Red-Lucy-Engineering/misfits/README.md

# "Misfits" - e-Paper (smart)watch

Open hardware e-Paper based smartwatch, fully user programmable.

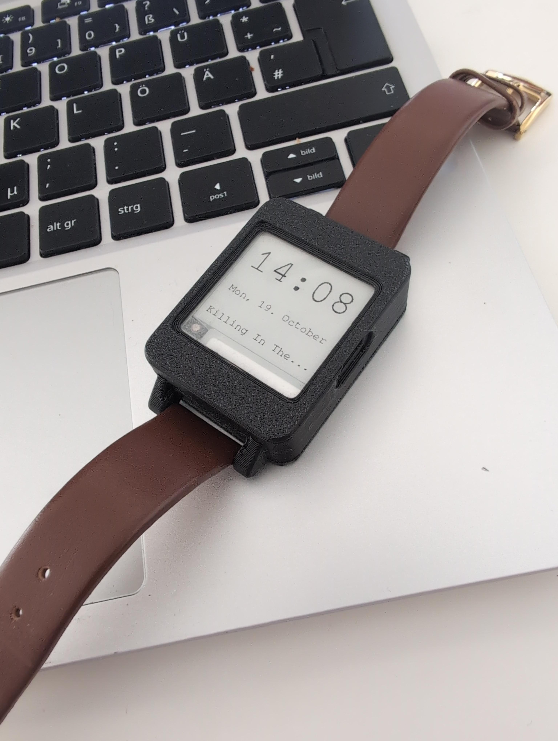
[picture p1: readme-media/misfits_assembled.jpg]
misfits assembled prototype

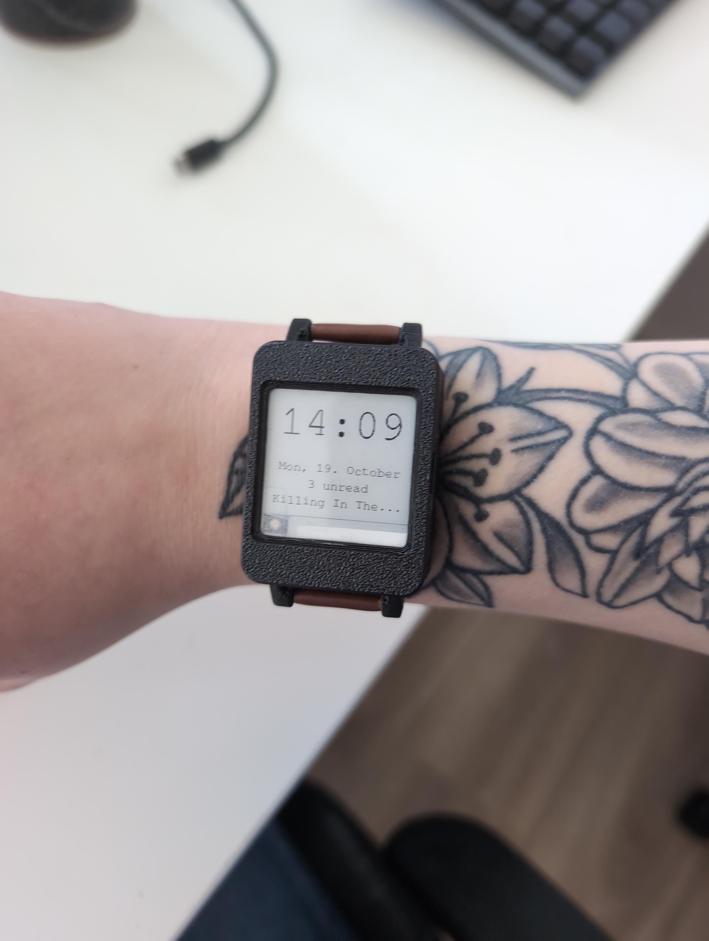
[picture p2: readme-media/misfits_assembled_wrist.jpg]
misfits assembled prototype, worn

misfits fixed prototype PCB, front
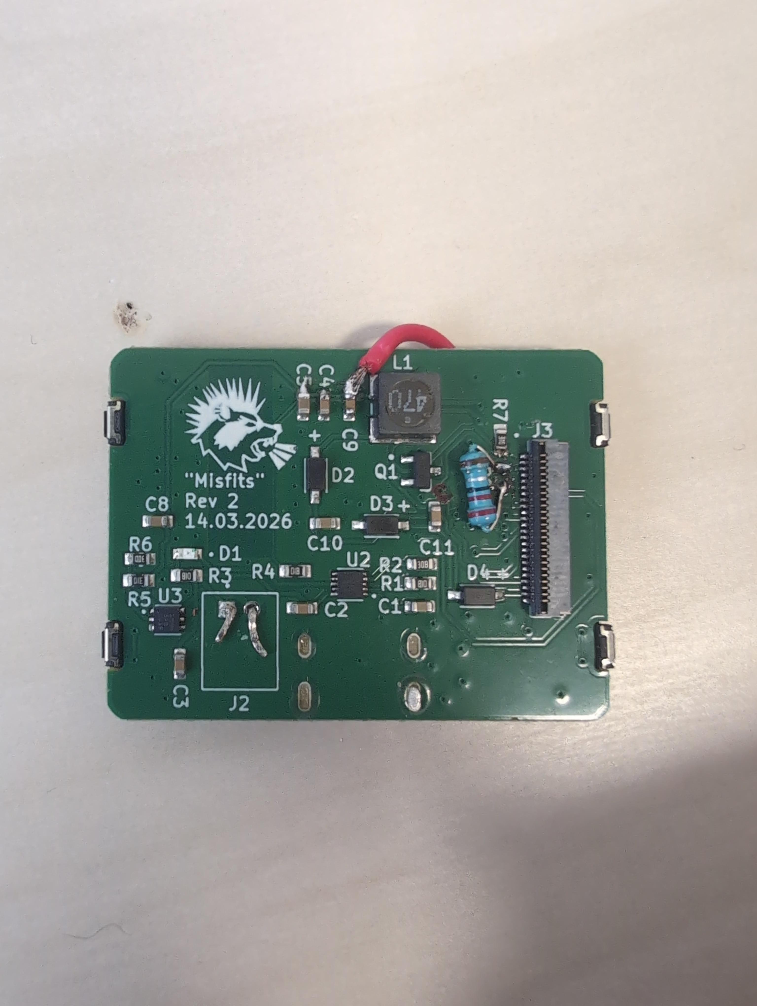
[picture p3: readme-media/misfits_fixed_pcb_back.jpg]
misfits fixed prototype PCB, back

misfits prototype without chassis
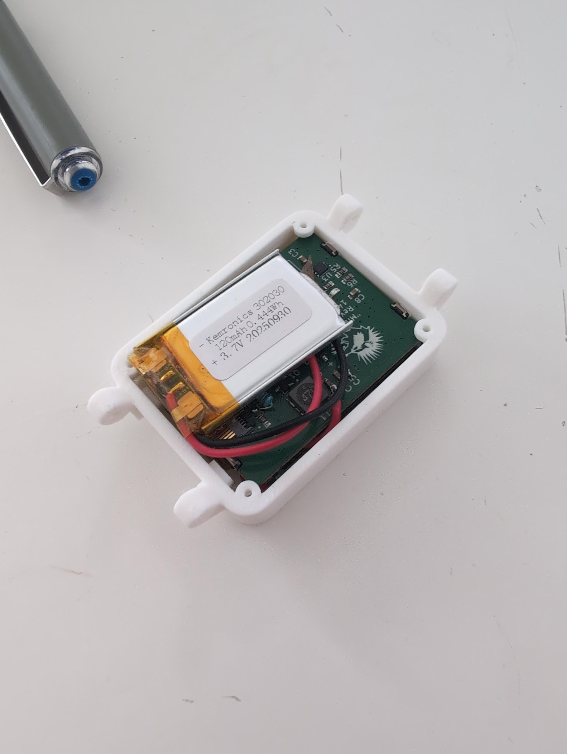
[picture p4: readme-media/misfits_partially_assembled.jpg]
misfits prototype partially assembled
