Red-Lucy-Engineering/misfits/readme-media/misfits-rev1-pcbdesign.png

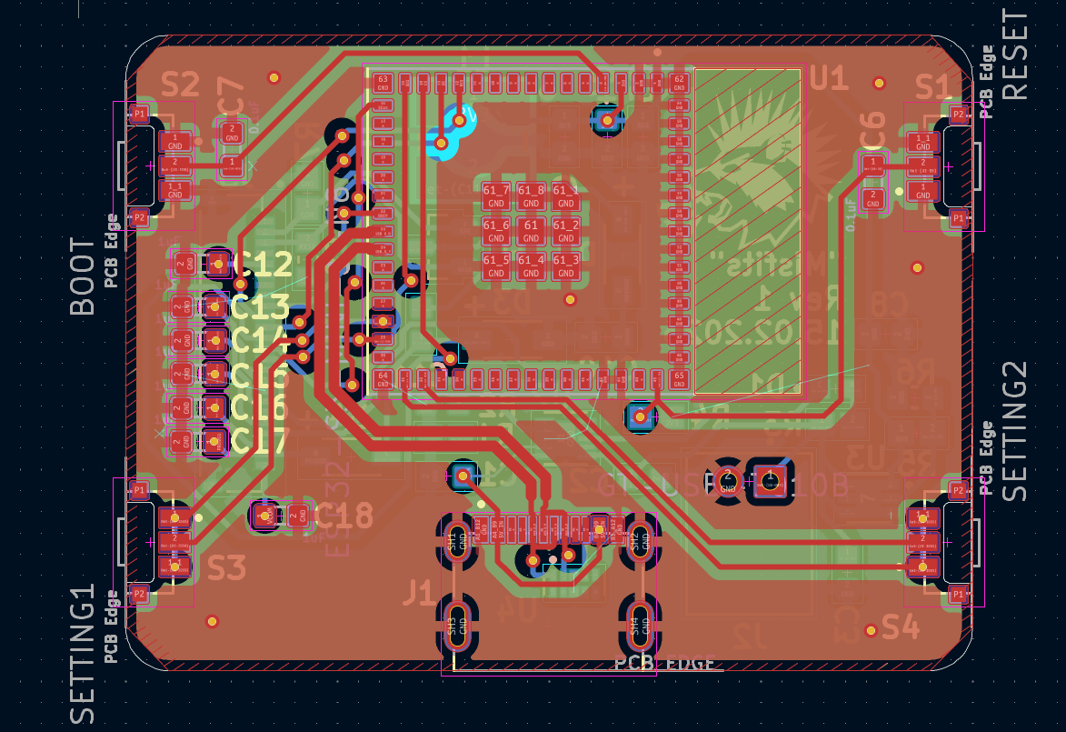
readme-media/misfits-rev1-pcbdesign.png
