Red-Lucy-Engineering/misfits/readme-media/misfits_no_chasiss.jpg

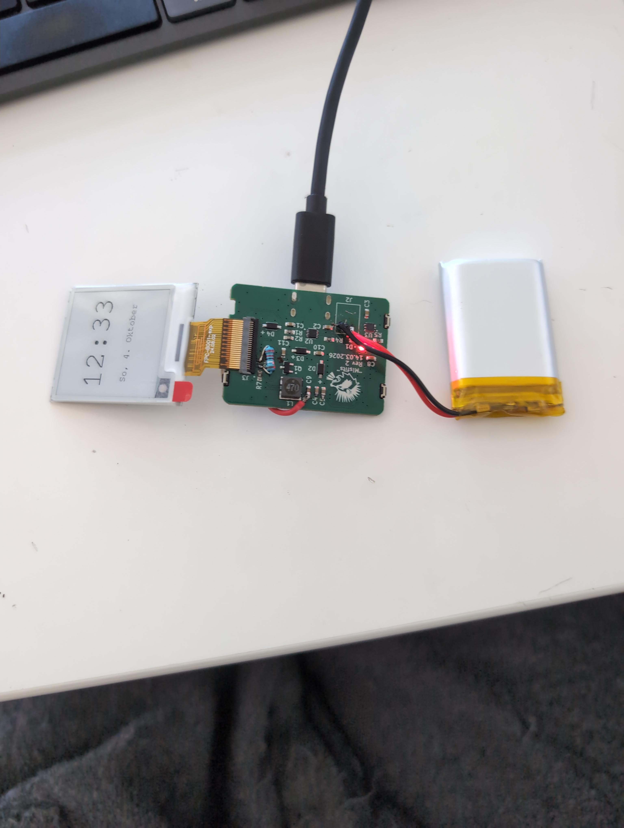
readme-media/misfits_no_chasiss.jpg
