Red-Lucy-Engineering/misfits/chassis/caseback.stl

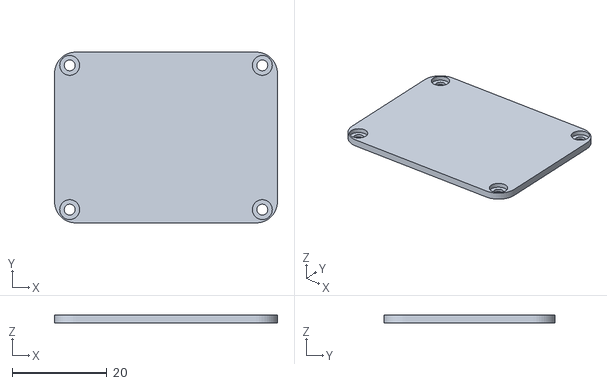
[picture p7: CAD file, 2026-10-24]
chassis/caseback.stl
47.0 x 36.0 x 1.60
