Red-Lucy-Engineering/misfits/chassis/body.stl

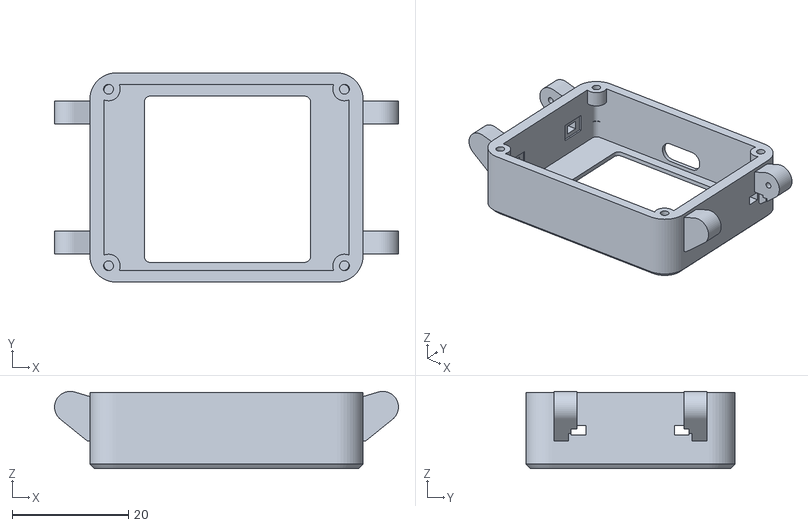
[picture p8: CAD file, 2026-10-24]
chassis/body.stl
59.2 x 36.0 x 13.3
