Red-Lucy-Engineering/misfits/TODO.md

# TODOs

- [x] Fix design mistakes
    - [x] *So* many grounds aren't connected because of shitty KiCAD zone defaults
    - [x] Correct placement of ESD protection chip
- [ ] Reduce component/assembly cost (currently $181.20 for 5 rev1 boards)
    - [ ] Panelize (Have multiple boards on a single PCB panel to avoid minimum
          assembly charges)
    - [x] Use cheaper parts, check for stock
        - [ ] SMT USB-C port, reduces hand assembly stuff
- [ ] Changes and New features
    - [ ] Better Microcontroller placement (less/no GND around the antenna)
    - [ ] Vibration motor
    - [ ] Heartrate monitor? (Optional, won't be added if there's no space or
          requires redesign)
