Red-Lucy-Engineering/misfits/misfits.kicad_pcb

## KiCad design misfits.kicad_pcb (2026-09-28)

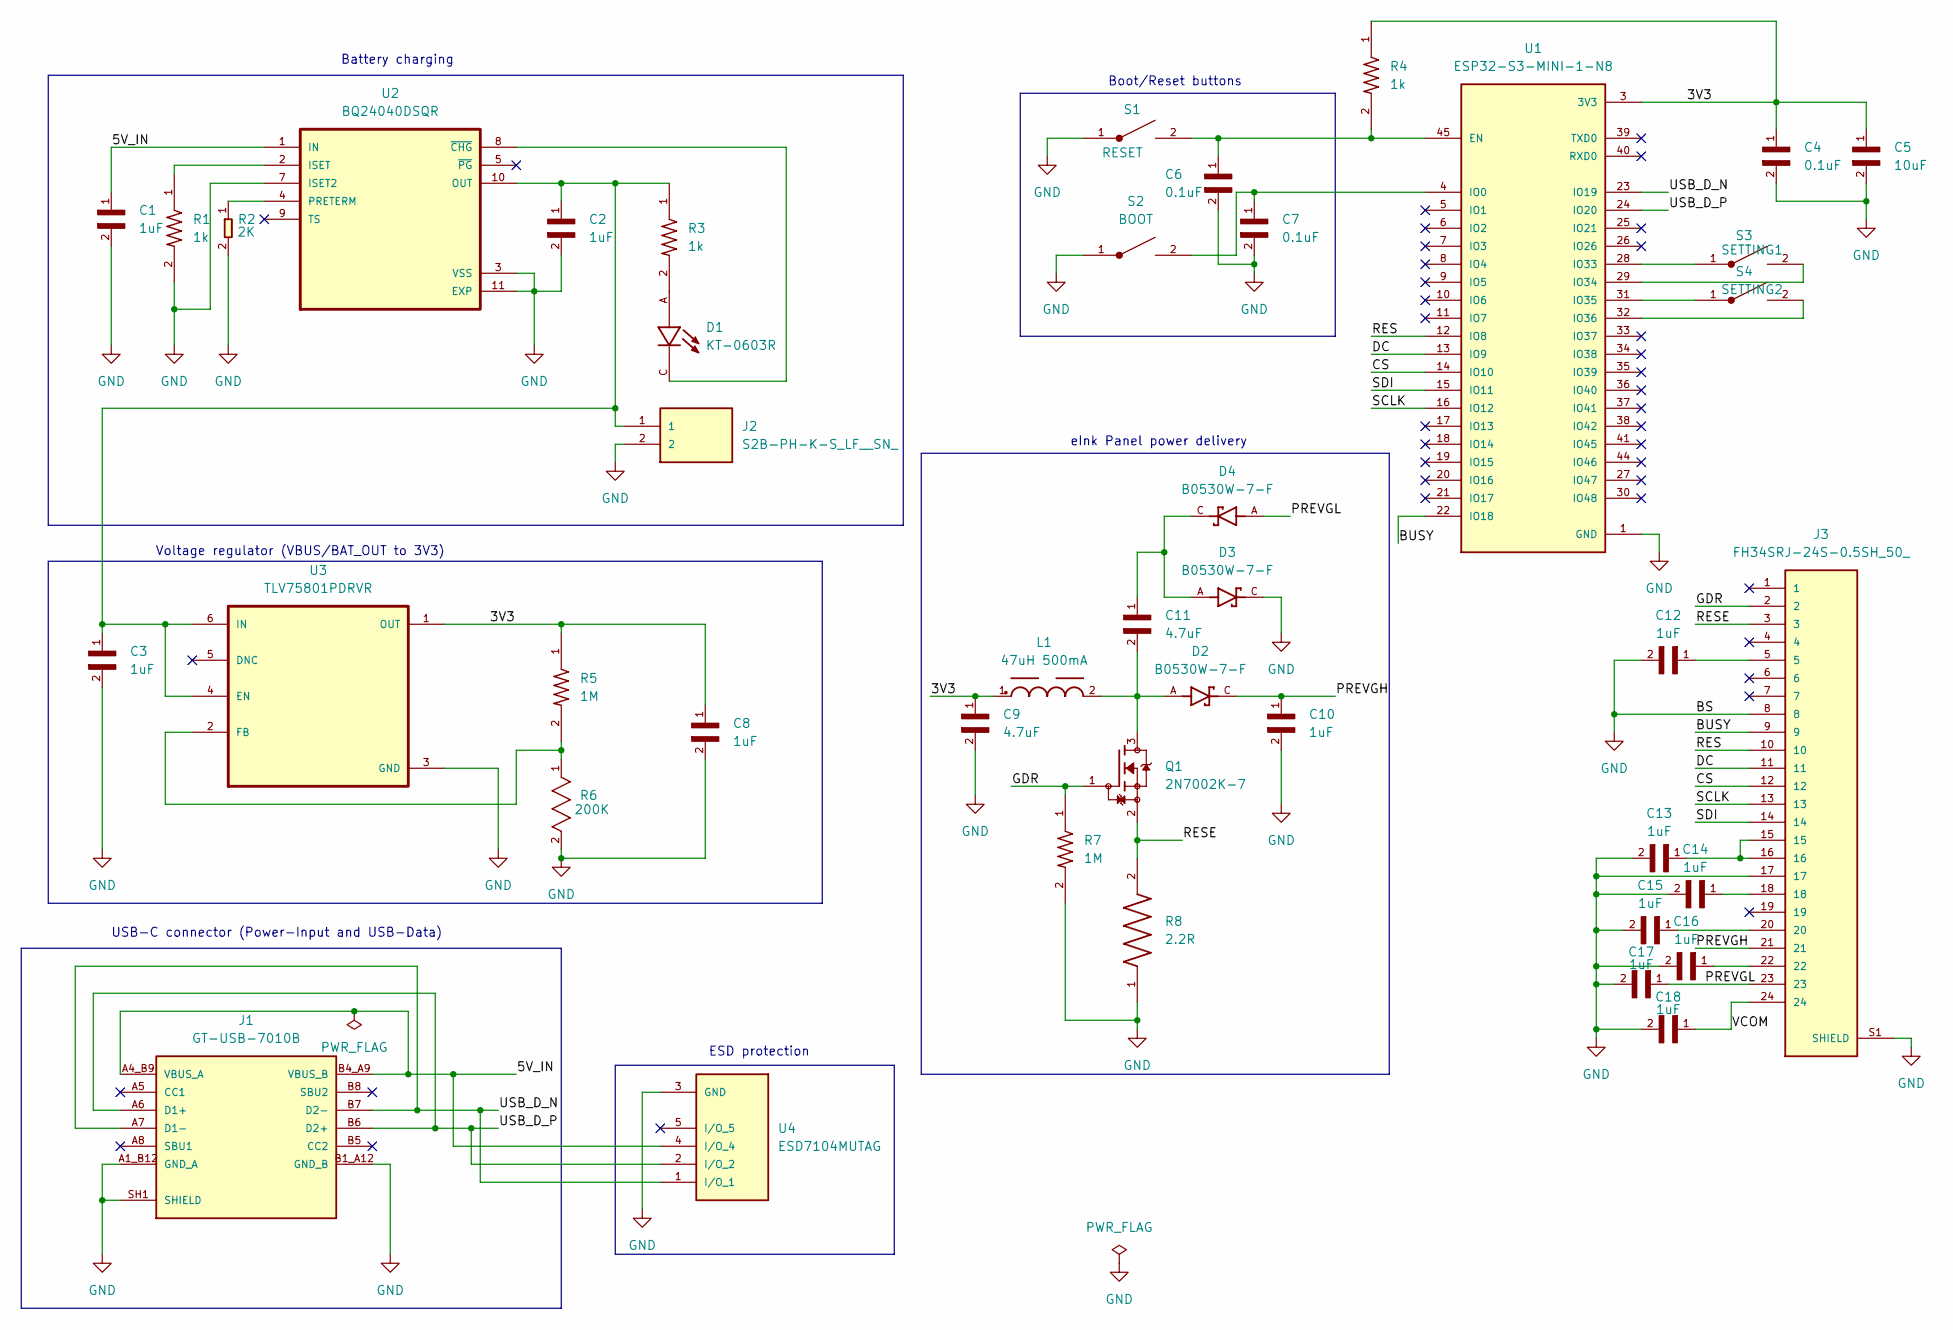
[picture p9: schematic misfits.kicad_sch, ${TITLE}]

Parts:
C1, C2, C3, C8, C10, C12, C13, C14, C15, C16, C17, C18: 1uF; CAPC1608X90N
C4, C6, C7: 0.1uF; CAPC1608X90N
C5: 10uF; CAPC1608X90N
C9, C11: 4.7uF; CAPC1608X90N
D1: KT-0603R; LED_KT-0603R; PARTREV 2013/01/24
D2, D3, D4: B0530W-7-F; SOD3715X145N; MPN C124188
J1: GT-USB-7010B; G-SWITCH_GT-USB-7010B; MPN C963217
J2: S2B-PH-K-S_LF__SN_; JST_S2B-PH-K-S_LF__SN_; MPN C173752
J3: FH34SRJ-24S-0.5SH_50_; HRS_FH34SRJ-24S-0.5SH_50_; MPN C324726
L1: 47uH 500mA; WE-TPC_4828; MPN C2046935
Q1: 2N7002K-7; SOT91P240X110-3N; MPN C85047
R1, R3, R4: 1k; RESC1607X60N
R2: 2K; R0603; MPN RC0603FR-072KL
R5, R7: 1M; RESC1607X60N
R6: 200K; RESC1608X60N; TOLERANCE ±1%; MPN RC0603FR-07200KL
R8: 2.2R; RESC1608X55N
S1: RESET; SW_EVP-AEDB2A; MPN C79150
S2: BOOT; SW_EVP-AEDB2A; MPN C79150
S3: SETTING1; SW_EVP-AEDB2A; MPN C79150
S4: SETTING2; SW_EVP-AEDB2A; MPN C79150
U1: ESP32-S3-MINI-1-N8; XCVR_ESP32-S3-MINI-1-N8
U2: BQ24040DSQR; SON40P200X200X80-11N; MPN C81080
U3: TLV75801PDRVR; SON65P200X200X80-7N; MPN C2876308
U4: ESD7104MUTAG; IC_ESD7104MUTAG; MPN C328026

Connections:
/3V3: C4.1, C5.1, C8.1, C9.1, L1.1, R4.1, R5.1, U1.3 (3V3), U3.1 (OUT)
/5V_IN: C1.1, J1.A4_B9 (VBUS_A), J1.B4_A9 (VBUS_B), U2.1 (IN), U4.4 (I/O_4)
/BUSY: J3.9, U1.22 (IO18)
/CS: J3.12, U1.14 (IO10)
/DC: J3.11, U1.13 (IO9)
/GDR: J3.2, Q1.1, R7.1
/PREVGH: C10.1, D2.C, J3.21
/PREVGL: C17.1, D4.A, J3.23
/RES: J3.10, U1.12 (IO8)
/RESE: J3.3, Q1.2, R8.2
/SCLK: J3.13, U1.16 (IO12)
/SDI: J3.14, U1.15 (IO11)
/USB_D_N: J1.A7 (D1-), J1.B7 (D2-), U1.23 (IO19), U4.1 (I/O_1)
/USB_D_P: J1.A6 (D1+), J1.B6 (D2+), U1.24 (IO20), U4.2 (I/O_2)
/VCOM: C18.1, J3.24
GND: C1.2, C2.2, C3.2, C4.2, C5.2, C6.2, C7.2, C8.2, C9.2, C10.2, C12.2, C13.2, C14.2, C15.2, C16.2, C17.2, C18.2, D3.C, J1.A1_B12 (GND_A), J1.B1_A12 (GND_B), J1.SH1 (SHIELD), J1.SH2 (SHIELD), J1.SH3 (SHIELD), J1.SH4 (SHIELD), J2.2, J3.8, J3.17, J3.S1 (SHIELD), J3.S2 (SHIELD), R1.2, R2.2, R6.2, R7.2, R8.1, S1.1, S1.1_1, S2.1, S2.1_1, U1.1 (GND), U1.2 (GND), U1.42 (GND), U1.43 (GND), U1.46 (GND), U1.47 (GND), U1.48 (GND), U1.49 (GND), U1.50 (GND), U1.51 (GND), U1.52 (GND), U1.53 (GND), U1.54 (GND), U1.55 (GND), U1.56 (GND), U1.57 (GND), U1.58 (GND), U1.59 (GND), U1.60 (GND), U1.61 (GND), U1.61_1 (GND), U1.61_2 (GND), U1.61_3 (GND), U1.61_4 (GND), U1.61_5 (GND), U1.61_6 (GND), U1.61_7 (GND), U1.61_8 (GND), U1.62 (GND), U1.63 (GND), U1.64 (GND), U1.65 (GND), U2.3 (VSS), U2.7 (ISET2), U2.11 (EXP), U3.3 (GND), U4.3 (GND), U4.8 (GND)
unnamed: C11.1, D3.A, D4.C
unnamed: C11.2, D2.A, L1.2, Q1.3
unnamed: C12.1, J3.5
unnamed: C13.1, J3.15, J3.16
unnamed: C14.1, J3.18
unnamed: C15.1, J3.20
unnamed: C16.1, J3.22
unnamed: D1.A, R3.2
unnamed: C6.1, R4.2, S1.2, U1.45 (EN)
unnamed: C7.1, S2.2, U1.4 (IO0)
unnamed: S3.1, S3.1_1, U1.28 (IO33)
unnamed: S3.2, U1.29 (IO34)
unnamed: S4.1, S4.1_1, U1.31 (IO35)
unnamed: S4.2, U1.32 (IO36)
unnamed: R1.1, U2.2 (ISET)
unnamed: C2.1, C3.1, J2.1, R3.1, U2.10 (OUT), U3.4 (EN), U3.6 (IN)
unnamed: R2.1, U2.4 (PRETERM)
unnamed: D1.C, U2.8 (~CHG)
unnamed: R5.2, R6.1, U3.2 (FB)

Notes on the sheet:
ESD protection
Boot/Reset buttons
USB-C connector (Power-Input and USB-Data)
Voltage regulator (VBUS/BAT_OUT to 3V3)
Battery charging
eInk Panel power delivery

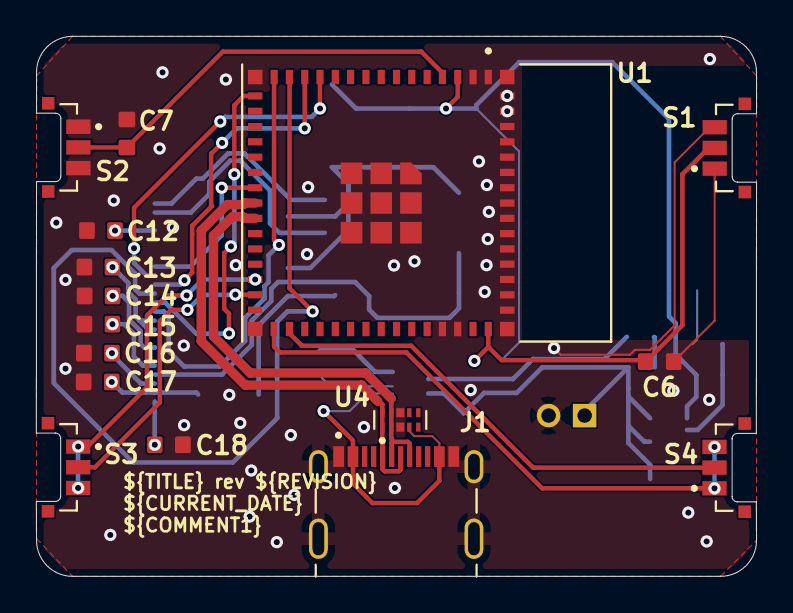
[picture p10: board misfits.kicad_pcb from above]

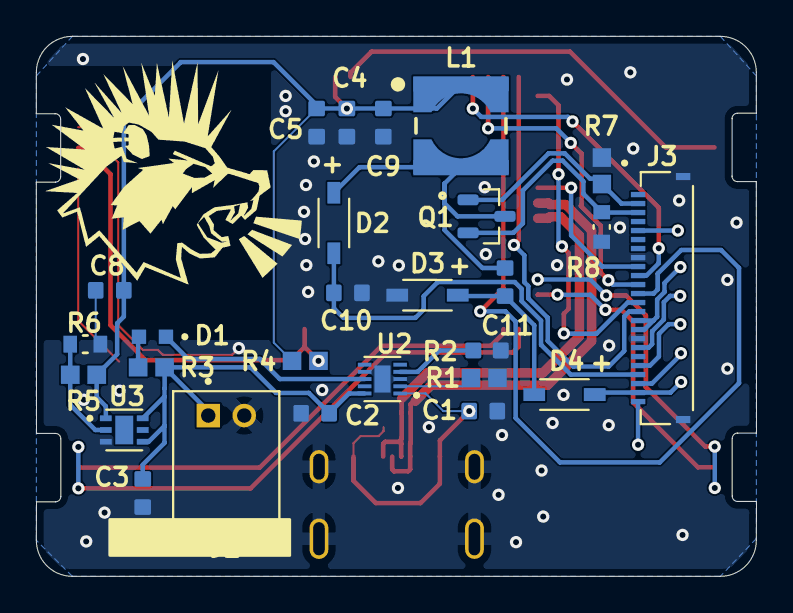
[picture p11: board misfits.kicad_pcb from below]

Board: 4 copper layers, 40.0 x 30.0 mm, 43 parts (27 on the bottom side), 35 nets.
