Red-Lucy-Engineering/misfits/(commit log)

2026-02-21 Disclaimer: WIP, not ready for use yet
    Which is also the reason there's a distinct lack of docs, descriptions,
    photos, etc. This is still early in the design process and the first PCB
    revision is in manufacturing right now (hasn't arrived yet).
2026-03-01 Update README.md
    Add a bit more description and a screenshot. Needs a GIF of the finished
    hardware device, a couple photos, and more explanation on what the
    point is, and how to program the thing.
2026-03-01 Add TODO.md
    TODO-list for misfits Revision 2. A couple changes are necessary.
    A) The PCB assembly is way too expensive. Cost needs to be cut without
    sacrificing usability or quality, otherwise it's not worth it for end
    users. Panelizing is an option for example, which makes the cost per
    board cheaper.
    B) There are some improvements to be made. A vibration motor of some
    sort would be helpful to alert users of calls and such, and depending on
    how viable it is, a heartrate monitor.
2026-03-07 Add TODO for fixing oopsie daisy
    🙂🙂🙂🙂🙂🙂🙂🙂🙂🙂🙂🙂
2026-03-11 Fix gnd copper fill zones and esd protection placement
    ESD protection placement was wrong, and the default "remove islands"
    crap from KiCAD (why the fuck is *that* the default?) failed to provide
    proper ground connections. These issues have been fixed now.
    [misfits.kicad_pcb]
2026-03-12 Connect copper zone islands with GND vias and double check GND pins
    Most copper zone islands have been connected with through-hole vias. The
    islands that are too small or have traces running through on the other
    side aren't connected, but since they aren't connected to any ground
    pins, this shouldn't be too big of an issue.
    [misfits.kicad_pcb]
2026-03-14 Fix DRC errors
    Assign pins missing from schematic properly, etc.
    [misfits.kicad_pcb, misfits.kicad_sch]
2026-03-14 Revision 2
    Revision 2 ready.
    Gerbers, Pick and place file and BoM generated and modified for JLCPCB
    [misfits-B_Mask.gbs, misfits-B_Paste.gbp, misfits-B_Silkscreen.gbo, misfits-Back.gbl, misfits-Edge_Cuts.gm1, misfits-F_Mask.gts, misfits-F_Paste.gtp, misfits-F_Silkscreen.gto]
2026-09-24 Fix wrong resistor value, change font and orient text correctly
    [misfits.kicad_pcb, misfits.kicad_sch]
2026-09-24 Parameterize schematic/PCB layout metadata
    [misfits.kicad_pcb, misfits.kicad_sch]
2026-09-24 Add silkscreen rectangle for serial no
    [misfits.kicad_pcb]
2026-09-25 Move Silkscreen around, add 3d models for things that need it
    [misfits.kicad_pcb]
2026-09-25 add MPN for parts that matter
    [misfits.kicad_sch]
2026-09-27 add MPN to PCB editor view as well for bom
    [misfits-B_Mask.gbs, misfits-B_Paste.gbp, misfits-B_Silkscreen.gbo, misfits-Back.gbl, misfits-Edge_Cuts.gm1, misfits-F_Mask.gts, misfits-F_Paste.gtp, misfits-F_Silkscreen.gto]
2026-09-27 new manufacturing files
    [misfits.kicad_sch, misfits_ESP32-S3-Mini_based_OSHW_smartwatch_3_bom.csv]
2026-09-27 add 3d export and openscad file for chassis
    [misfits-chassis.scad]
2026-09-28 [chassis] restart from scratch
    [misfits-chassis.scad]
2026-09-28 remove openscad-chassis, as a couple changes are imminent
    It's gonna be 100% obsolete before I finish anyways
    [misfits.kicad_pcb]
2026-10-03 changes to standard symbols/footprints
    [misfits.kicad_sch]
2026-10-04 start chassis: display
    [main.scad]
2026-10-05 prototype chassis for test and dogfeeding
    [bottom.stl, full.stl, main.3mf, main.scad, top.stl]
2026-10-05 change filename in license header to main.c
    [main.3mf]
2026-10-16 Allow for light sleep without impacting functionality
    so a 159mAh battery is a viable fit...hopefully, am testing rn
2026-10-24 Add case openscad script + stl
